anasderkaoui/AutoRCX/README.md

# <p align="center">AutoRCX </b>

Unlocking the full potential of technology with the awe-inspiring autonomous RC car. Whether you want to engage in intense races or experience the joy of exploration, this RC car has got you covered. Its cutting-edge technology will leave you breathless, as you marvel at the incredible capabilities that it possesses. Get ready to be swept away by the excitement and endless possibilities that await you!

# <p align="center">
# <p align="center">
