anasderkaoui/AutoRCX/Additional reports/README.md

This repository is dedicated to more in-depth information about the JETSON NANO dev kit card and ROS utility.</br>
For more flexibility, don't forget Ctrl+F to filter out directly what you want to know !
Some of the topics discussed here are : 
- [Boot and run the Jetson Nano from SSD](https://github.com/anasderkaoui/AutoRCX/blob/main/Additional%20reports/4th%20report.md) instead of SD card or eMMC (internal flash memory)
- Access Jetson Nano via [remote desktop using XRDP or VNC](https://github.com/anasderkaoui/AutoRCX/blob/main/Additional%20reports/1st%20report.md)
- Using Lidar to [perform SLAM as well as autonomous navigation](https://github.com/anasderkaoui/AutoRCX/blob/main/Additional%20reports/6th%20report.md)
- [ssh problem fix host key](https://github.com/anasderkaoui/AutoRCX/blob/main/Additional%20reports/5th%20report.md) while conecting the Jetson Nano board
- [Navigation setup and test](https://github.com/anasderkaoui/AutoRCX/blob/main/Additional%20reports/6th%20report.md) of the AutoRCX
- [Bind USB port with a static name on Linux](https://github.com/anasderkaoui/AutoRCX/blob/main/Additional%20reports/7th%20report.md) and run sudo commands at each openning of the terminal window/tab. And [enable bluetooth automatically at each startup](https://github.com/anasderkaoui/AutoRCX/blob/main/Additional%20reports/7th%20report.md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)
 - [Autonomous navigation fixes and car dimensions](https://github.com/anasderkaoui/AutoRCX/blob/main/Additional%20reports/9th%20report.md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)
 - All the [autonomous navigation config files](https://github.com/anasderkaoui/AutoRCX/blob/main/Additional%20reports/6th%20report.md)
