anasderkaoui/AutoRCX/Odometry/README.md

This is a code to calculate the distance traveled and the current speed of our robot using the **KY-040 rotary encoder**
