anasderkaoui/AutoRCX/CAD (CAO) and Laser Cutting/README.md

In this repository you will find some 3D models for an ARDUINO UNO card case or box along with its lid.
