anasderkaoui/AutoRCX/C++ & Arduino/README.md

Hello!

This is a morse code that I programmed using ARDUINO IDE. It is able to translate any letter or number into its morse code and blink the Arduino UNO card's LED accordingly to each response (dash or dot).

Transfer the 5 files above to your ARDUINO desktop app, hook up your ARDUINO UNO card and try it out !
