anasderkaoui/AutoRCX/IMU/LSM9DS1/README.md

## This is the driver for the LSM9DS1 IMU
