anasderkaoui/AutoRCX/IMU/BNO055/README.md

# Setup the BNO055 IMU

## Hardware part:

- To use this IMU with a raspberry pi4, make sure to connect it just like [the previous IMU](https://github.com/anasderkaoui/AutoRCX/tree/main/SLAM). This type of connection is for **I2C communication**.
- In order to use this IMU with a computer using **USB (UART communication)**, you will need the I2C to USB converter like [the one in the following image](https://www.amazon.fr/DSD-TECH-SH-U09C2-Adaptateur-Programmation/dp/B07TXVRQ7V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) ([backup link](https://www.iot-store.com.au/collections/iot-networking-comms/products/industrial-usb-to-ttl-converter-ft232rl)):
  <p align="center">
      
- Make sure to connect RX ➜ SDA, TX ➜ SCL, Vin ➜ Vcc, Gnd ➜ Gnd and **connect the 3V pin to the PS1 pin, both present on the IMU itself**:
  <p align="center">
      

## Software part:

- [This is the ros2 driver](https://github.com/flynneva/bno055.git) for it.
- Make sure you modify [this line](https://github.com/flynneva/bno055/blob/45e1ff16936101711260c9fda63fbad99376ce3b/launch/bno055.launch.py#L38) in the launch file to "bno055_params_i2c.yaml" if you are using the IMU in I2C mode.
- Also change the "i2c_bus" in [this line](https://github.com/flynneva/bno055/blob/45e1ff16936101711260c9fda63fbad99376ce3b/bno055/params/bno055_params_i2c.yaml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) of the param file to the corresponding one (usually 0 or 1).
- Install required dependencies: `rosdep install --from-paths src -i`
- Finally run: `ros2 launch bno055 bno055.launch.py`
