anasderkaoui/AutoRCX/ROS2 and Arduino wired-wireless communication/IMU (MPU6050) RVIZ2/README.md

A code to get the output of the MPU6050 on RVIZ2 using micro-ros !<br>
**[This package](https://github.com/anasderkaoui/AutoRCX/tree/main/IMU/MPU6050) allows the same thing but without going through micro-ros. It also features a thorough explanation of the TF transform tree!**
