anasderkaoui/AutoRCX/Additional reports/1st report.md

After the final report from the previous sessions, you may have seen that I bricked my Nvidia Jetson Nano card because of some faulty commands.
Today, I succeeded at reflashing it and bringing it back to its normal state.
Here are the steps that I have followed to unbrick it:<br >

1- Follow the steps described in **[this document](https://auvidea.eu/download/Software)**, note that I have an Auvidea carrier board. In this document you will find the **step by step guide to reflash the jetson nano**. An internet connection is required to flash the card.<br >

2- You may encounter some problems as I did. If so, here are some solutions:<br >
   - ERROR 8 : The card did not successfuly boot into recovery mode. You will have to check connection between the jumpers used and the card.<br >
   - ERROR 1 : It has something to do with system cache. All you need to do is restart the laptop you are using to flash the card and change the cable connecting the jetson nano to the laptop.<br >
   - If you encounter any other persisting errors, change the usb cable and the usb port connected to the laptop.

After this, the card should be now good to go. You will need an external monitor and a keyboard to reconfigure it to its original state.<br >

Finally, I want to add one problem that I ran into while trying to move user data from /home to /media/storage/home as explained in [the 19th session's report](https://github.com/anasderkaoui/AutoRCX/blob/main/My%20project%20reports/19th%20session's%20report.md?plain=1).<br >
While following the steps described in that session, I added **<>** to the UUID number that was assigned to my disk partition. After that, the card booted in emergency mode and did not want to boot normaly even after unplugging and plugging back the power cable. I needed an external monitor and a keyboard to figure this out.

rn_image_picker_lib_temp_26d85087-8dd3-40f0-8c19-2a6d464f14e2

After searching, it turns out that these signs **<>** were the problem.
After the card had booted in emergency mode, I pressed the ENTER key to continue.

rn_image_picker_lib_temp_004da67b-501c-4a24-9669-6b4906c3dffc

Then I simply modified the file that contained the UUID number and deleted the <> signs.<br >

rn_image_picker_lib_temp_d4bf532e-9744-44f4-9b78-a2ac7e8fbe27

Eventually, I had to restart the card and the problem was solved !<br >

**As a bonus, I will guide you through two methods, one being more effective than the other, to get the output of your Jetson Nano on your laptop screen without using any external peripherals !**<br >

> [!NOTE]
> You can buy a **wireless HDMI cable** that will save you all the work that follows!

**1- In the first method we will be using VNC (Virtual Network Computing)** (The least effective method because the output is not very smooth). In this method you will need a monitor, a keyboard and if you want also a mouse.
  - First, after booting up the system, you will need to enter this command line in the terminal:<br >
    `sudo vim /usr/share/glib-2.0/schemas/org.gnome.Vino.gschema.xml` This command will open up a file and we will add a key to it.
  - Add this key as shown in the screenshot below:<br >
                  `<key name=’enabled’ type=’b’>`<br >
                  `<summary>Enable remote access to the desktop</summary>`<br >
                  `<description>`<br >
                  `If true, allows remote access to the desktop via the RFB`<br >
                  `protocol. Users on remote machines may then connect to the`<br >
                  `desktop using a VNC viewer.`<br >
                  `</description>`<br >
                  `<default>true</default>`<br >
                  `</key>`<br >
  


  - After that, we will need to compile the file. Run this command to do so: `sudo glib-compile-schemas /usr/share/glib-2.0/schemas`<br >
  - Now search for "Desktop Sharing" in the search bar (can be accessed by pressing the "Windows" key) and open it.<br >
  - Tick the “Allow other users to view your desktop” and also “Allow other users to control your desktop” checkmarks. Then make sure “You must confirm each access to this machine” is turned off. Finally tick the “Require the user to enter this password” checkmark, and enter a password for the VNC session.



  - Open "startup applications" using the search bar. Now, click Add at the right of the box, then type ‘Vino’ in the name box, and then in the command box enter **/usr/lib/vino/vino-server**. Click Save at the bottom right of the box, and then close the app.



  - Next, we need to disable encryption of the VNC connection to get things working. To do this, open the terminal and enter the following commands:<br >
    `gsettings set org.gnome.Vino require-encryption false`<br >
    `gsettings set org.gnome.Vino prompt-enabled false`<br >
  - Now, find the IP address of your Jetson nano board by using "ifconfig" or "hostname -I" command.



In this example it's 192.168.0.106 (You can find it in wlan0->inet)
  - Finally, use this command to check whether your VNC server is running or not: `ps -ef|grep vnc`



Now all you have to do left is install a VNC server (VNC viewer for example) on your laptop and connect to the Jetson Nano using its IP address and password.

**2- Moving on to the better method**, in which we will be using XRDP. XRDP is a free and open-source implementation of Microsoft RDP (Remote Desktop Protocol) server that enables operating systems other than Microsoft Windows (such as Linux) to provide a fully functional RDP-compatible remote desktop experience.
  - First, you need to install XRDP. To do so, open the terminal and run these commands:<br >
    `sudo apt update`<br >
    `sudo apt install xrdp`<br >
    `sudo systemctl enbale xrdp`<br >
    `sudo reboot`<br >
  - After rebooting the system, go to your laptop, search for "Remote Desktop Connection" and open it. Then, click on show options and then type the IP address of your Jetson Nano and username as shown in the screenshot below.



  - Finally, you will be taken to a screen where you need to enter the password of the Jeston Nano to access it.

Now you are able to see the output of the card and use your laptop's keyboard and trackpad to control your Jetson Nano.

Sources:
- [Jetson Nano Remote Connection Methods](https://raspberry-valley.azurewebsites.net/NVIDIA-Jetson-Nano/)
- [Jetson Nano Remote VNC Access](https://medium.com/@bharathsudharsan023/jetson-nano-remote-vnc-access-d1e71c82492b)
