anasderkaoui/AutoRCX/Additional reports/5th report.md

Some warnings and problems related to ssh connecting the Jetson Nano board:

- ... Add correct host key in C:\\Users\\Anas/.ssh/known_hosts to get rid of this message. ... -> Fix: ssh-keygen -R *ip_address_or_hostname*
