anasderkaoui/AutoRCX/Code/NVIDIA JETSON code.md

This is the link to the code of the Autonomous RC car. It is coded automatically via various plateforms like Cuda and Keras.

Link : [Drive Colab Notebooks](https://colab.research.google.com/drive/1U2XdAKOw0V6aW4nJHnTzeedeiRepkBv0?usp=sharing)
