anasderkaoui/AutoRCX/Youness' reports/Report 9.docx

The project involves developing an autonomous driving controller for an electric vehicle. The driving control model was trained using the model.h5 file. The aim is to use this model to control the vehicle's steering and acceleration.

The old code included an implementation of the SimplePIController class which is responsible for controlling the vehicle's steering. However, the code contained some errors and needed improvements to function correctly.

The following modifications were made to the old code:

I removed the import of the h5py library as it was not used in the code.

I updated the fixed speed to 20.

I added prints to display the steering and acceleration values after they have been updated.

I updated the code to save the image only if the image directory is not empty.

I adjusted the SimplePIController class to set the target value to 20.

I defined the values for the variables vehicle_mass, brake_deadband, decel_limit, accel_limit, wheel_radius, wheel_base, steer_ratio, max_lat_accel, and max_steer_angle.

But the new code have a problem because when i run it in the shell he don’t told me any thing, he just goes back to the line like that :

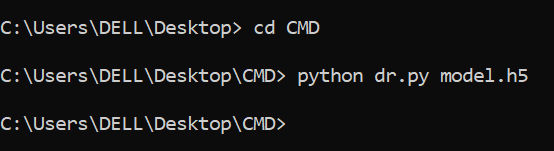
[picture p6: figure]

So I hope that I can fix this problem the next session.

The new code :

import argparse

import base64

import json

import numpy as np

import socketio

import eventlet

import eventlet.wsgi

import time

from PIL import Image

from PIL import ImageOps

from flask import Flask, render_template

from io import BytesIO

from keras.models import load_model

import h5py

# Fix error with Keras and TensorFlow

import tensorflow as tf

tf.compat.v1.disable_eager_execution()

sio = socketio.Server()

app = Flask(__name__)

model = None

prev_image_array = None

class VehicleParams:

def __init__(self):

self.vehicle_mass = 2500 # kg

self.brake_deadband = .1 # range [0,1]

self.decel_limit = -5 # m/s^2

self.accel_limit = 1 # m/s^2

self.wheel_radius = 0.3 # meters

self.wheel_base = 2.8 # meters

self.steer_ratio = 14.8

self.max_lat_accel = 3 # m/s^2

self.max_steer_angle = 8 # degrees

class SimplePIController:

def __init__(self, Kp, Ki):

self.Kp = Kp

self.Ki = Ki

self.set_point = 20

self.error = 0.0

self.integral = 0.0

def run(self, measurement):

self.error = self.set_point - measurement

self.integral += self.error

return self.Kp * self.error + self.Ki * self.integral

class Controller:

def __init__(self, vehicle_params):

self.vehicle_params = vehicle_params

self.steering_controller = SimplePIController(0.1, 0.002)

self.throttle_controller = SimplePIController(0.3, 0.1)

def control(self, current_velocity, dbw_enabled, linear_velocity, angular_velocity):

if not dbw_enabled:

self.throttle_controller.reset()

return 0., 0., 0.

current_velocity = self.velocity_mps_to_kmph(current_velocity)

steering = self.steering_controller.run(current_velocity)

throttle = self.throttle_controller.run(linear_velocity)

brake = 0

if linear_velocity == 0. and current_velocity < 0.1:

throttle = 0

brake = 700 # N*m - to hold the car in place if we are stopped at a light. Acceleration - 1m/s^2

elif throttle < .1 and abs(current_velocity - linear_velocity) < .1:

throttle = 0

decel = max(self.vehicle_params.decel_limit,

self.vehicle_params.accel_limit)

brake = abs(decel) * self.vehicle_params.vehicle_mass * self.vehicle_params.wheel_radius # Torque N*m

return steering, throttle, brake

def reset(self):

self.steering_controller.reset()

self.throttle_controller.reset()

def velocity_mps_to_kmph(self, velocity_mps):

return velocity_mps * 3
