anasderkaoui/AutoRCX/Youness' reports/Report.docx

During this session, we successfully achieved our goal by generating the module.h5 file which contains the information necessary for running the car. However, it is still necessary to develop code that transfers this information to the Udacity software using the shell, in order to establish a connection between the two.

This code implements a deep learning based autonomous driving model using Tensorflow and Keras. It first mounts a Google Drive, then imports the necessary libraries. It then reads a data set called "driving_log.csv" from Google Drive and displays it using Pandas.

The code also performs exploratory data analysis by building a histogram of the car's steering direction and then eliminating directions that are overrepresented in the data. This ensures that the model does not focus on abnormal cases.

The code then loads the images and steering data from the data set and splits it into training and validation sets using scikit-learn's train_test_split.

Finally, the code defines a neural network model using Keras. The model is then trained on the training data and tested on the validation data. The model is saved as a "module.h5" file at the end of the process.

Voici le code :

import argparse

import base64

from datetime import datetime

import os

import shutil

import numpy as np

import socketio

import eventlet

import eventlet.wsgi

from PIL import Image

from flask import Flask

from io import BytesIO

import tensorflow as tf

import h5py

sio = socketio.Server()

app = Flask(__name__)

model = None

prev_image_array = None

class SimplePIController:

def __init__(self, Kp, Ki):

self.Kp = Kp

self.Ki = Ki

self.set_point = 0.

self.error = 0.

self.integral = 0.

def set_desired(self, desired):

self.set_point = desired

def update(self, measurement):

# proportional error

self.error = self.set_point - measurement

# integral error

self.integral += self.error

return self.Kp * self.error + self.Ki * self.integral

controller = SimplePIController(0.1, 0.002)

# 781 is good to 9

# 881

set_speed = 10

controller.set_desired(set_speed)

@sio.on('telemetry')

def telemetry(sid, data):

if data:

# The current steering angle of the car

steering_angle = data["steering_angle"]

# The current throttle of the car

throttle = data["throttle"]

#print("throttle", throttle)

# The current speed of the car

speed = data["speed"]

# The current image from the center camera of the car

imgString = data["image"]

image = Image.open(BytesIO(base64.b64decode(imgString)))

image_array = np.asarray(image)

steering_angle = float(model.predict(image_array[None, :, :, :], batch_size=1))

throttle = controller.update(float(speed))

print(steering_angle, throttle)

send_control(steering_angle, throttle)

# save frame

if args.image_folder != '':

timestamp = datetime.utcnow().strftime('%Y_%m_%d_%H_%M_%S_%f')[:-3]

image_filename = os.path.join(args.image_folder, timestamp)

image.save('{}.jpg'.format(image_filename))

else:

# NOTE: DON'T EDIT THIS.

sio.emit('manual', data={}, skip_sid=True)

@sio.on('connect')

def connect(sid, environ):

print("connect ", sid)

send_control(0, 0)

def send_control(steering_angle, throttle):

sio.emit(

"steer",

data={

'steering_angle': steering_angle.__str__(),

'throttle': throttle.__str__()

},

skip_sid=True)

if __name__ == '__main__':

parser = argparse.ArgumentParser(description='Remote Driving')

parser.add_argument(

'model',

type=str,

help='Path to model h5 file. Model should be on the same path.'

)

parser.add_argument(

'image_folder',

type=str,

nargs='?',

default='',

help='Path to image folder. This is where the images from the run will be saved.'

)

args = parser.parse_args()

model = tf.keras.models.load_model(args.model)

if args.image_folder != '':

print("Creating image folder at {}".format(args.image_folder))

if not os.path.exists(args.image_folder):

os.makedirs(args.image_folder)

else:

shutil.rmtree(args.image_folder)

os.makedirs(args.image_folder)

print("RECORDING THIS RUN ...")

else:

print("NOT RECORDING THIS RUN ...")

# wrap Flask application with engineio's middleware

app = socketio.Middleware(sio, app)

# deploy as an eventlet WSGI server

eventlet.wsgi.server(eventlet.listen(('', 4567)), app)
