anasderkaoui/AutoRCX/Article/AutoRCX presentation.pptx

## AUTORCX La voiture autonome

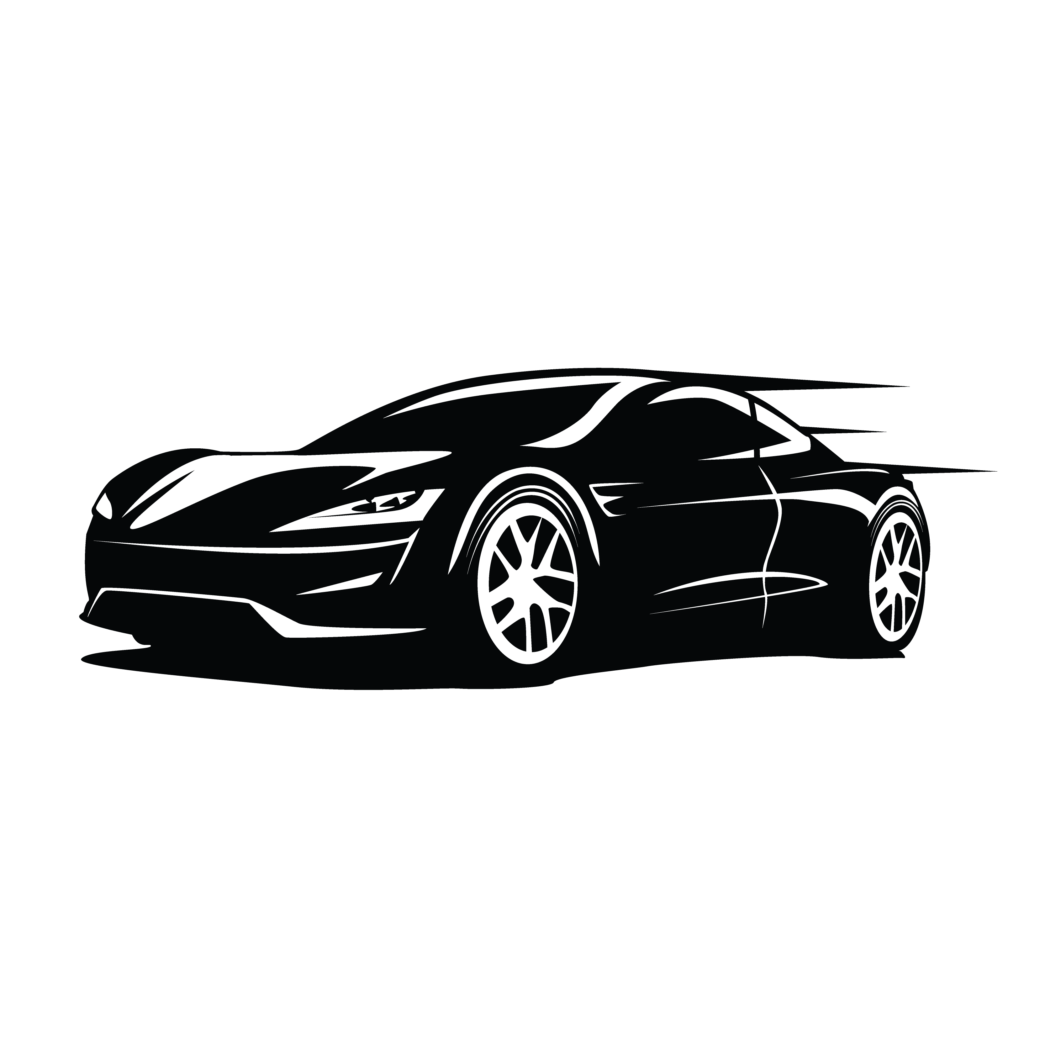
[picture p14: figure]

Youness TALEB - Anas DERKAOUI

## INTRODUCTION

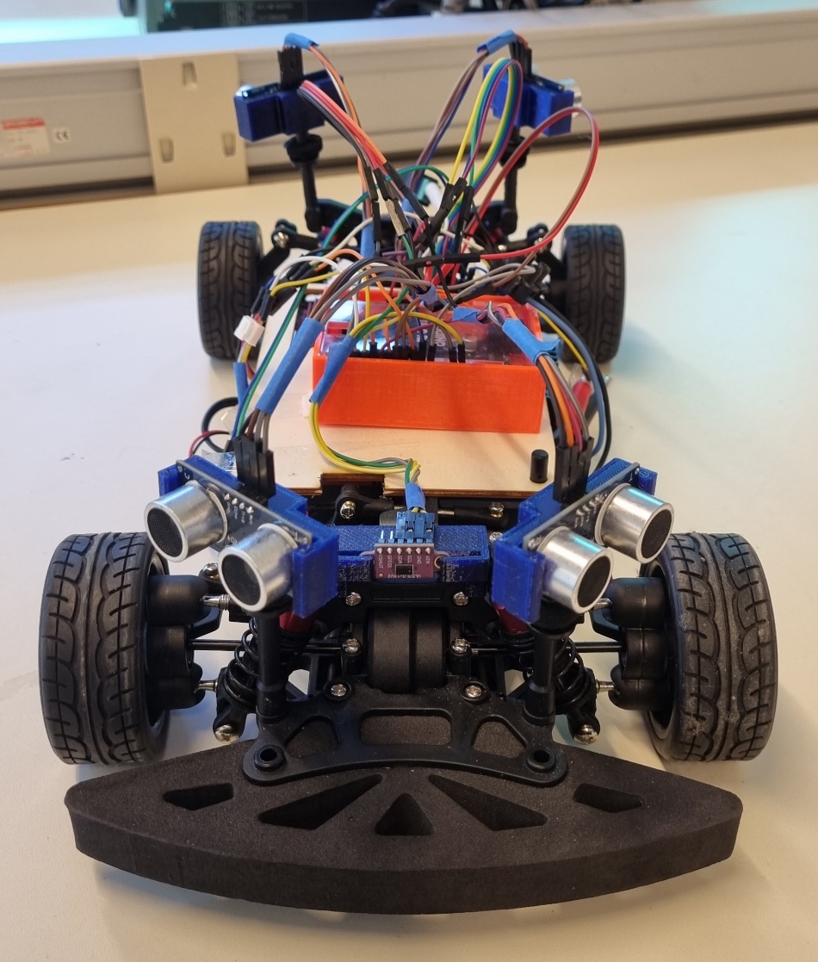
[picture p15: figure]

- Autonomie
- Détection des obstacles
- Aucune intervention externe
- Evitement des obstacles
- Changement de direction

## Composants

Carte Arduino UNO

4 Capteurs ultrason

Capteur laser

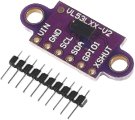
[picture p16: figure]
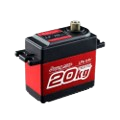
[picture p17: figure]

Servomoteur

Microcontrôleur

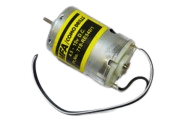
[picture p18: figure]

Moteur DC 4,5 -15V

## Alimentation

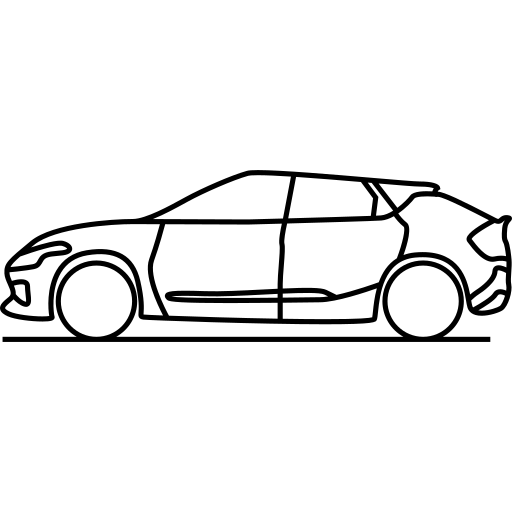
[picture p19: figure]
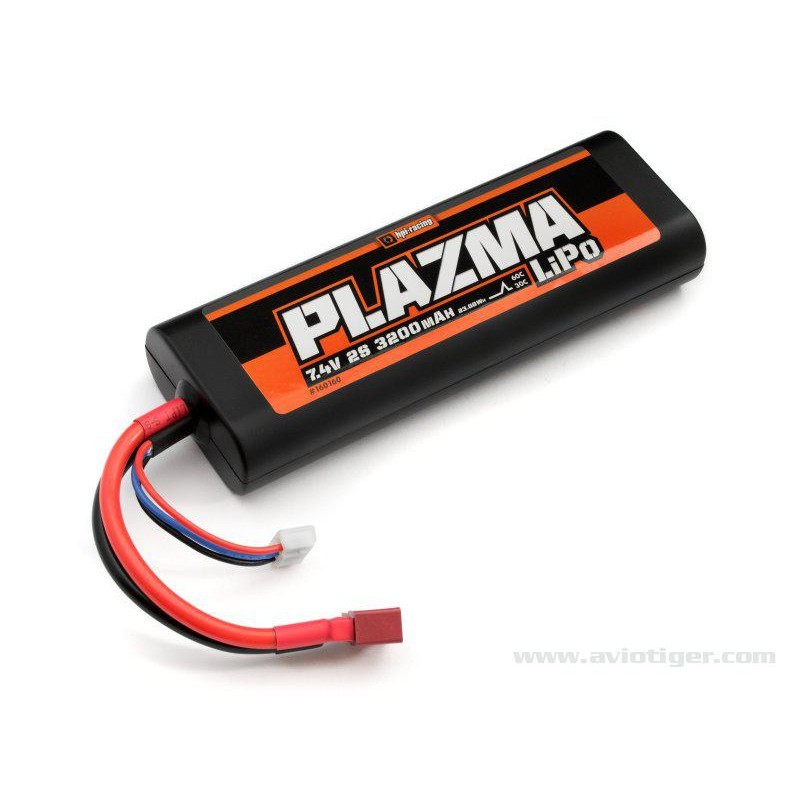
[picture p20: figure]
Alimentation RC Hpi-racing BATTERIE LIPO 7.4V 3200 MAH 30C...
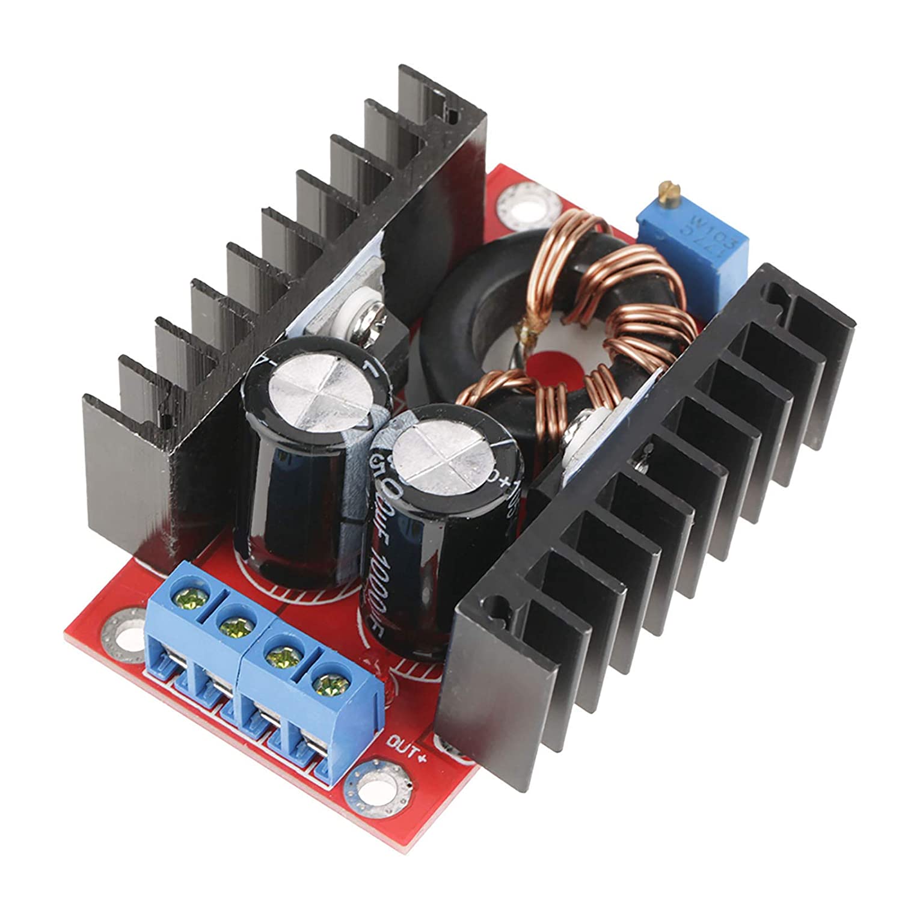
[picture p21: figure]
Convertisseur DC-DC, Module d'augmentation de puissance durable, 150W pratique et utile pour l'alimentation de voiture 12-32V à 12-35V Équipements électroniques Ordinateur portable : Amazon.fr: Informatique

2 convertisseurs
DC-DC

Batterie Li-Po 7,4V ou Ni-MH 7,2V

## Construction et entraînement du modèle 01 02 03

Utilisation de Keras et OpenCV

Prétraitement des données et définition de l'architecture du CNN

Entraînement et sauvegarde du modèle

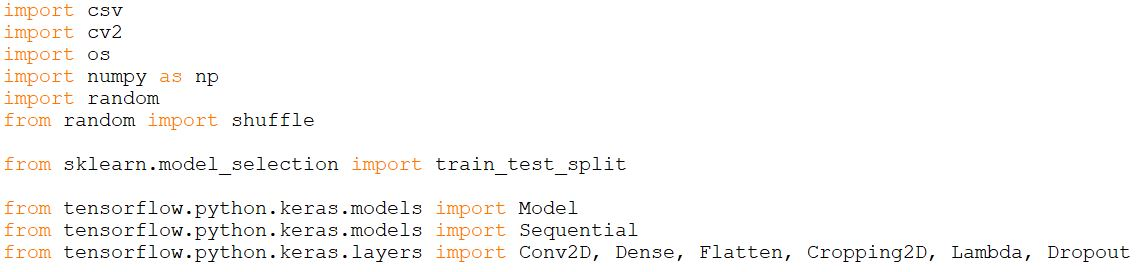
[picture p22: figure]

## Architecture du CNN

- Couches de convolution, de mise à plat (Flatten) et de régularisation (Dropout)
- Fonction de perte et optimiseur

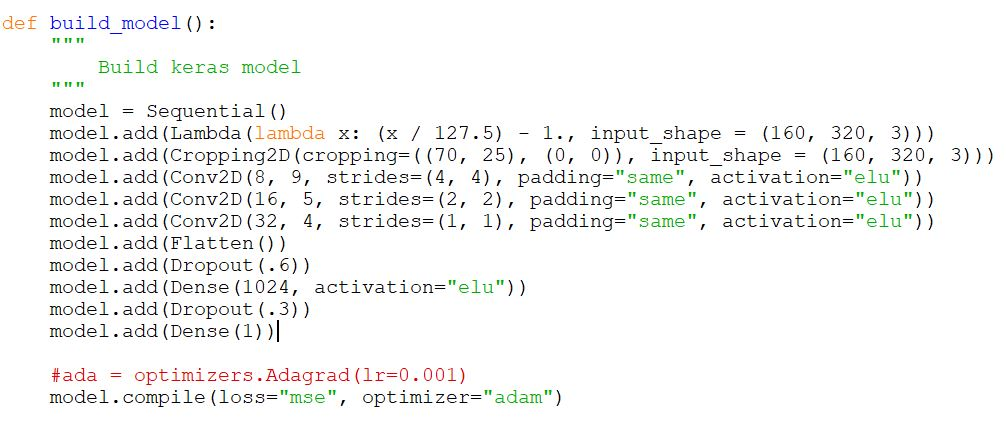
[picture p23: figure]
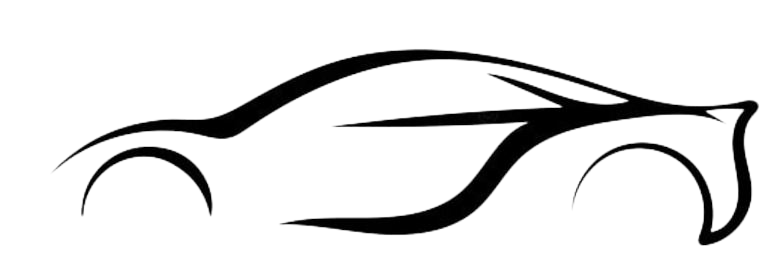
[picture p24: figure]

## Déploiement du modèle dans le simulateur

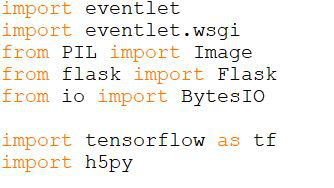
[picture p25: figure]

- Communication avec le simulateur à l'aide de Socket.IO et Flask
- Chargement du modèle pré-entraîné TensorFlow
- Contrôle du véhicule en fonction des prédictions du modèle

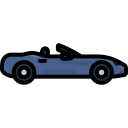
[picture p26: figure]

## Fonction de télémétrie

Lecture et prétraitement des données du simulateur

Prédiction de l'angle de braquage à l'aide du modèle

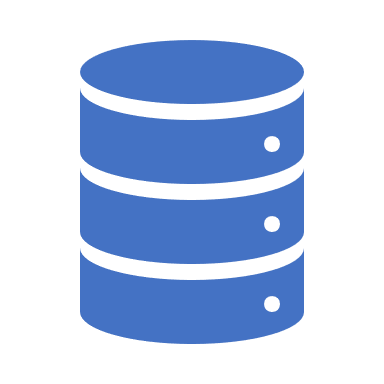
[picture p27: figure]
Base de données avec un remplissage uni
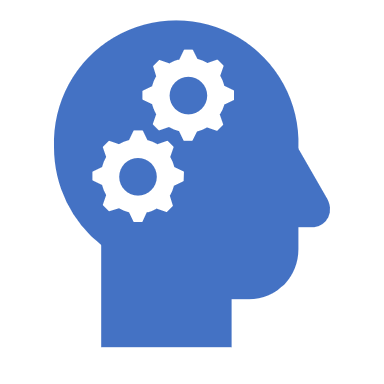
[picture p28: figure]
Head with Gears

Envoi des nouvelles valeurs d'angle de braquage et d'accélérateur au simulateur

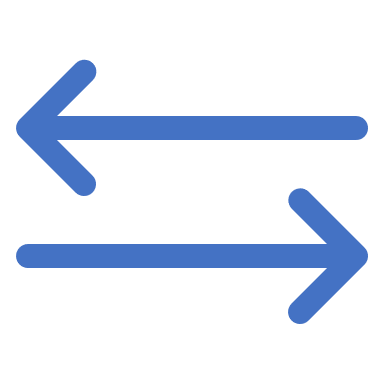
[picture p29: figure]
Transférer avec un remplissage uni

## Merci pour votre attention

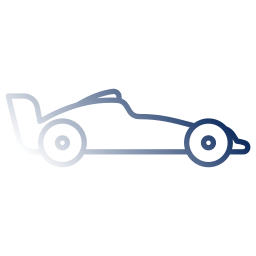
[picture p30: figure]
