anasderkaoui/AutoRCX/Youness' reports/Report 1st session.pdf

## Report 1st session

The objective of this session was to try to write the code for each component. So far, I’ve managed to write the code for the ultrasonic sensor and the code for the SIM800L. However, I have not yet tried the one of the SIM800L because I don’t have it on site, and while trying the one of the ultrasonic sensor I faced some obstacles such as: a cable that was damaged, this made me waste a lot of time looking for where the problem is, but also a mistake that comes from me because I did not pay attention to the sensor Ultrasonic works with microseconds and not with milliseconds.

Here is the complete code that combines that of the two components :

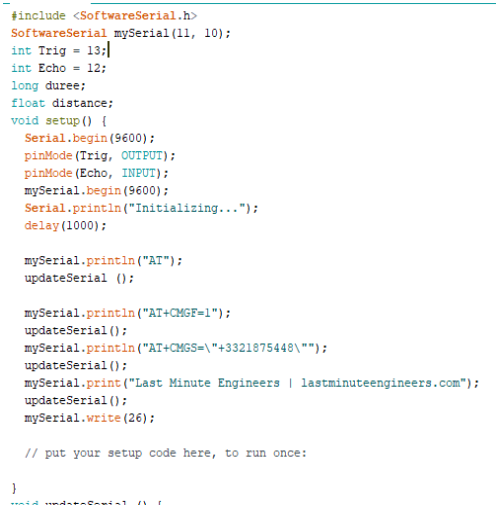
[picture p31: figure]
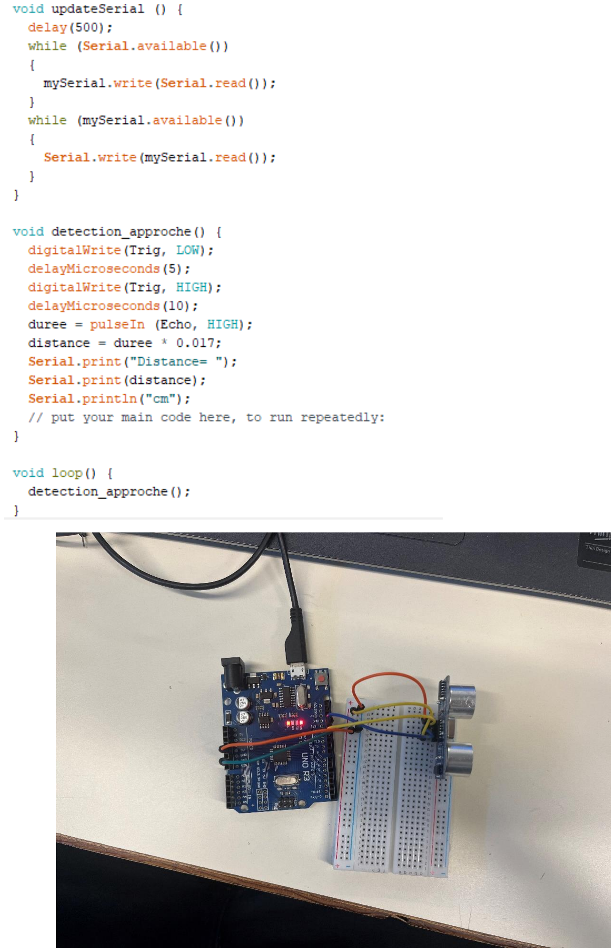
[picture p32: page 2]
