anasderkaoui/AutoRCX/Youness' reports/Report 3rd session.pdf

## Report 3th session

This session, I tried to size the chassis of the car to optimize the space. It took me a long time to find a good picture of the chassis on the internet, to avoid building the whole chassis by myself. I finally managed to import it to Inskape and vectorize it. Then I did the laser cutting, and here’s the result. I also have my comrade Anas to make the code ESP-WROOM-32. This chassis will be used just for the first tests, and after that when we’ve finished all the tests and we’ll have nothing missing, we’ll build a personal chassis that’s more personal and stiff.

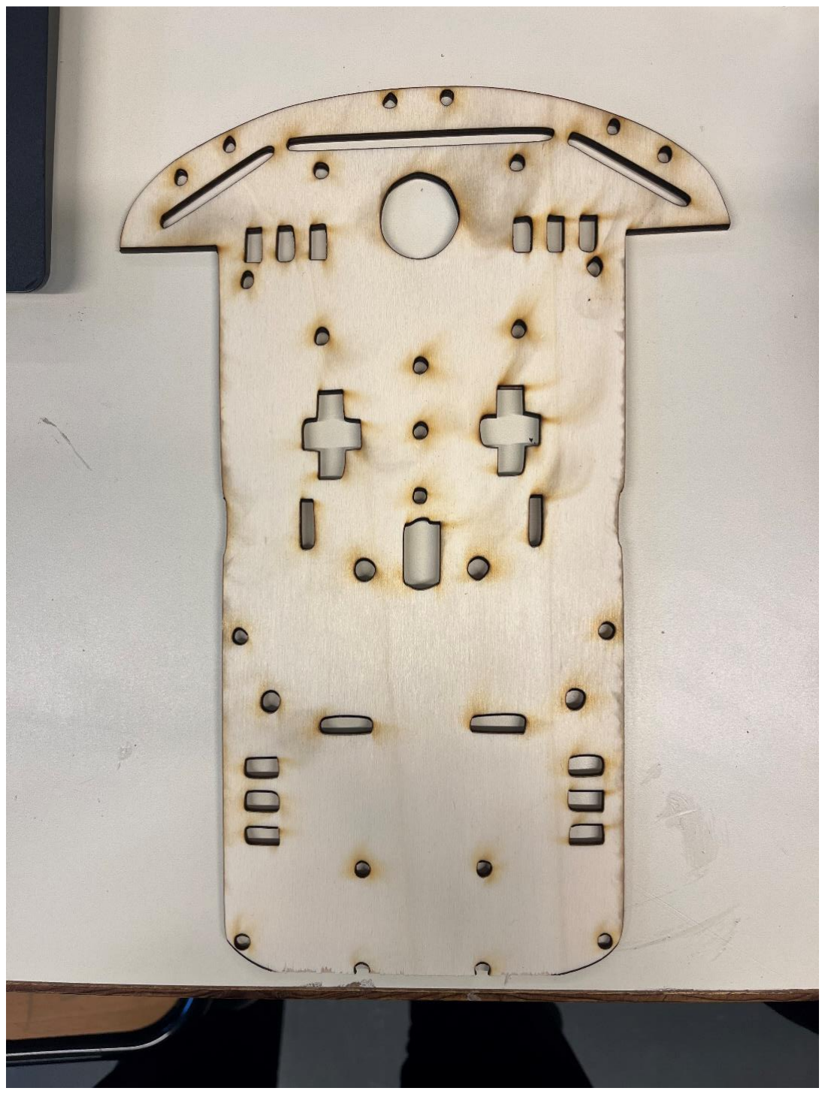
[picture p35: figure]
