anasderkaoui/AutoRCX/Youness' reports/Rapport 6.docx

6th Report

This session and the next two will be devoted to writing the code and testing it on Udacity. We started by installing Anaconda, which is a software containing all the modules we will need to use. We started by using Virtualenv in our Shell, which is a tool for creating isolated Python virtual environments. virtualenv creates a folder that contains all the executables needed to use the packages that a Python project might require.

Then I installed my environment and created my dependencies, which are the following:

Tensorflow, matplotlib, numpy, Image, opencv-python, sklearn, jupyter, scipy, flask-socketio.

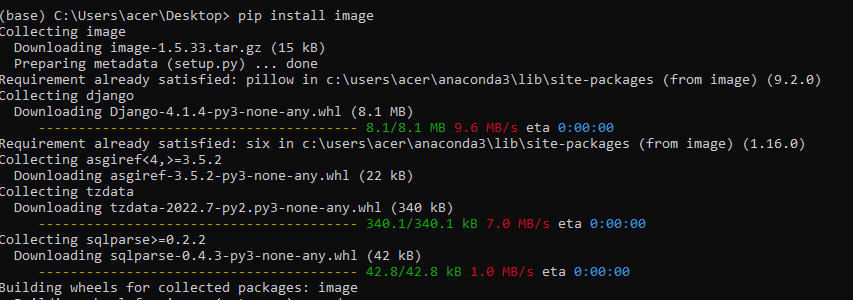
[picture p68: figure]

I train the model using a convolutional neural network predicting one linear output. As I said above, the architecture is built in the build_method method. In order to reduce the overfitting, I used data augmentation by flipping each image of the dataset and by using the left/right camera. I also add dropout just after the last convolution and after the first Fully connected layer. The model used an Adam optimizer, so the learning rate was not tuned manually. Then, for the architecture, the size and the number of filters have been set by many trial and error. For the training data, I used a combination of the central, left and right camera, each one, randomly flip. The training data is a subset of 85% of the total dataset.

THE MODEL.PY :

| import cv2 import csv
| import os
| import numpy as np
| import random
| from random import shuffle
| from sklearn.model_selection import train_test_split
| from tensorflow.python.keras.models import Model
| from tensorflow.python.keras.models import Sequential
| from tensorflow.python.keras.layers import Conv2D, Dense, Flatten, Cropping2D, Lambda, Dropout
| DATA_PATH = "data/driving_log.csv"
| DATA_IMG = "data/"
| def build_model():
| """
| Build keras model
| """
| model = Sequential()
| model.add(Lambda(lambda x: (x / 127.5) - 1., input_shape = (160, 320, 3)))
| model.add(Cropping2D(cropping=((70, 25), (0, 0)), input_shape = (160, 320,
| model.add(Conv2D(8, 9, strides=(4, 4), padding="same", activation="elu"))
| model.add(Conv2D(16, 5, strides=(2, 2), padding="same", activation="elu"))
| model.add(Conv2D(32, 4, strides=(1, 1), padding="same", activation="elu"))
| model.add(Flatten())
| model.add(Dropout(.6))
| model.add(Dense(1024, activation="elu"))
| model.add(Dropout(.3))
| model.add(Dense(1))
| model.compile(loss="mse", optimizer="adam")
| return model
| def get_data(log_content, index_list, batch_size, strict=True):
| """
| Return Data from the simulator
| **input:
| *log_content (2dim Array) Data from the log file
| *index_list: Index to used to create each batch
| *batch_size (Int) Size of each batch
| """
| images, rotations = [], []
| while True:
| if not strict:
| shuffle(index_list)
| for index in index_list:
| # Futur angle correction
| angle_correction = [0., 0.25, -.25]
| i = random.choice([0, 1, 2]) # [Center, Left, Right]
| img = cv2.imread(os.path.join(DATA_IMG, log_content[index][i]).replace(" ", ""))
| if img is None: continue
| img = cv2.cvtColor(img, cv2.COLOR_BGR2RGB)
| rotation = float(log_content[index][3])
| rotation = rotation + angle_correction[i]
| if random.random() > 0.5:
| img = cv2.flip(img, 1)
| rotation = rotation * -1
| images.append(img)
| rotations.append(rotation)
| if len(images) >= batch_size:
| yield np.array(images), np.array(rotations)
| images, rotations = [], []
| def main():
| """
| Main function to train the model
| """
| with open(DATA_PATH, "r") as f:
| content = [line for line in csv.reader(f)]
| random_indexs = np.array(range(len(content)))
| train_index, valid_index = train_test_split(random_indexs, test_size=0.15)
| model = build_model()
| print("Train size = %s" % len(train_index))
| print("Valid size = %s" % len(valid_index))
| BATCH_SIZE = 64
| model.fit_generator(
| generator=get_data(content, train_index, BATCH_SIZE, strict=False),
| steps_per_epoch=len(train_index) / BATCH_SIZE,
| validation_data=get_data(content, valid_index, BATCH_SIZE, strict=True),
| validation_steps=len(valid_index) / BATCH_SIZE,
| epochs=12)
| model.save("model.h5")
| if __name__ == '__main__':
| main()
