anasderkaoui/AutoRCX/IMU/MPU9250/src/magnetometer_scatter.png

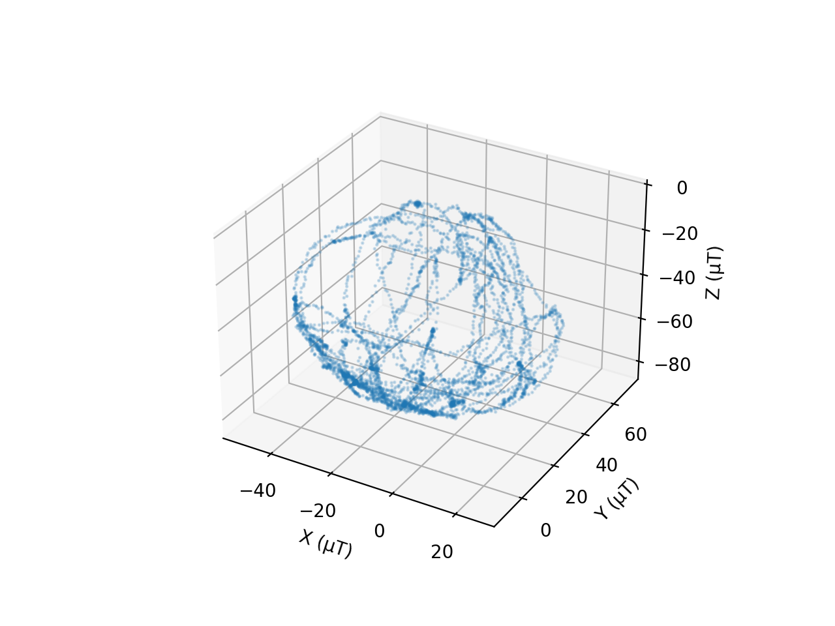
IMU/MPU9250/src/magnetometer_scatter.png
