anasderkaoui/AutoRCX/CAD (CAO) and Laser Cutting/Boitier Youness TALEB.stl

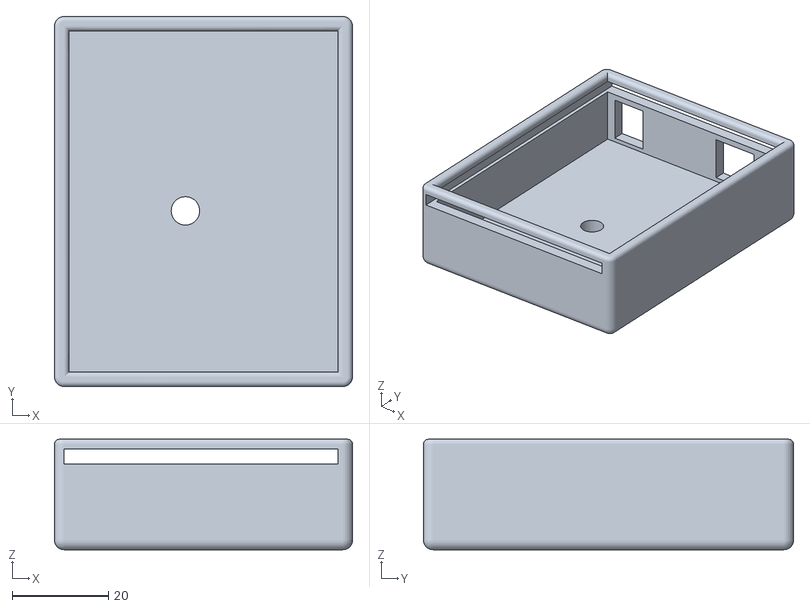
[picture p70: CAD file, 2022-11-16]
CAD (CAO) and Laser Cutting/Boitier Youness TALEB.stl
62.0 x 77.0 x 23.0
