anasderkaoui/AutoRCX/(list of files, cad)

Other CAD files:
CAD (CAO) and Laser Cutting/boîte arduino version finale.f3d
