anasderkaoui/AutoRCX/IMU/MPU9250/src/test_data.csv

Time | Distance (m) | Velocity (m/s) | Acceleration (m/s²) | Jerk (m/s³)
1753370297.869718 | 0.0 | 0.0 | 0.0 | 0.0
1753370298.066915 | 0.0 | 0.0 | 0.0 | 0.0
1753370298.1669445 | 0.0 | 0.0 | 0.0 | 0.0
1753370298.2673845 | 0.0 | 0.0 | 0.0 | 0.0
1753370298.4670632 | 0.0 | 0.0 | 0.0 | 0.0
1753370298.5673578 | 0.0 | 0.0 | 0.0 | 0.0
1753370298.7672765 | 0.0 | 0.0 | 0.0 | 0.0
1753370298.8673503 | 0.0 | 0.0 | 0.0 | 0.0
1753370299.0672915 | 0.0 | 0.0 | 0.0 | 0.0
1753370299.2672644 | 0.0 | 0.0 | 0.0 | 0.0
1753370299.4671724 | 0.0 | 0.0 | 0.0 | 0.0
1753370299.5673802 | 0.0 | 0.0 | 0.0 | 0.0
1753370299.7672908 | 0.0 | 0.0 | 0.0 | 0.0
1753370299.8673255 | 0.0 | 0.0 | 0.0 | 0.0
1753370300.0715659 | 0.0 | 0.0 | 0.0 | 0.0
1753370300.2672007 | 0.0 | 0.0 | 0.0 | 0.0
1753370300.4672937 | 0.0 | 0.0 | 0.0 | 0.0
1753370300.5673182 | 0.0 | 0.0 | 0.0 | 0.0
1753370300.6673536 | 0.0 | 0.0 | 0.0 | 0.0
1753370300.867202 | 0.0 | 0.0 | 0.0 | 0.0
1753370300.967373 | 0.0 | 0.0 | 0.0 | 0.0
1753370301.1672008 | 0.0 | 0.0 | 0.0 | 0.0
1753370301.2672422 | 0.0 | 0.0 | 0.0 | 0.0
1753370301.4675748 | 0.0 | 0.0 | 0.0 | 0.0
1753370301.6671386 | 0.0 | 0.0 | 0.0 | 0.0
1753370301.8671196 | 0.0 | 0.0 | 0.0 | 0.0
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
