anasderkaoui/AutoRCX/C++ & Arduino/Main.ino

// This is where the characters need to be typed so as to translate them in morse code and blink the LED light of the Arduino UNO board accordingly

#include "Traducteur.h" // Includes "Traducteur.h" that has all the needed functions for the morse code to work (including "LettreMorse.h")

const int led = 13;  // The pin 13 that corresponds to the LED on the Arduino UNO board
Traducteur traducteur=Traducteur();  // Creates an object of type "Traducteur" to allow us to use the functions in "Traducteur.h" that are defined in "Traducteur.cpp"
char phrase[100] = "Put the phrase/word to translate in here";

void setup() {

  Serial.begin(9600);  // The speed at which we can communicate with the Arduino UNO R3 board
  pinMode(led,OUTPUT);  // Defining pin that will be used as an output (13 our this case)
  Serial.print("Translation of : ");
  Serial.println(phrase);
  traducteur.morse(phrase); // The input which will be translated to morse code
  Serial.println(" End of translation! ");

}

void loop() {
  
}
