anasderkaoui/AutoRCX/(commit log)

2022-11-15 Add files via upload
    Boîtier pour carte Arduino Uno R3
    [boîte arduino version finale.f3d]
2022-11-25 Rename Couvercle version finale.svg to CAD (CAO) and Laser Cutting/Couvercle version finale.svg
2022-11-25 Rename Couvercle Youness TALEB.svg to CAD (CAO) and Laser Cutting/Couvercle Youness TALEB.svg
2022-11-27 Rename LettreMorse.cpp.ino to C++ & Arduino/LettreMorse.cpp.ino
2022-11-27 Rename LettreMorse.h to C++ & Arduino/LettreMorse.h
2022-11-27 Rename Main.ino to C++ & Arduino/Main.ino
2022-11-27 Rename Traducteur.cpp to C++ & Arduino/Traducteur.cpp
2022-11-27 Rename Traducteur.h to C++ & Arduino/Traducteur.h
2023-01-19 Update and rename Autonomous RC Car code.md to Autonomous RC Car ARDUINO code.md
2023-01-21 Update Autonomous RC Car ARDUINO code.md
2023-01-27 Create NVIDIA JETSON code
2023-01-27 Update and rename NVIDIA JETSON code to NVIDIA JETSON code.md
2023-01-27 Update NVIDIA JETSON code.md
2023-05-08 Create New improved ARDUINO code for AutoRCX.md
2023-05-08 Rename New improved ARDUINO code for the AutoRCX.md
2023-05-08 Rename Autonomous RC Car ARDUINO code.md
2024-02-28 Update add IMU soon
2024-04-08 How to visualize the IMU README.md
2024-06-05 Add difference between base link and base footprint
2024-06-05 ADD info about imu and base link
2024-06-09 Code to send/test control over arduino
2024-06-16 Added rviz config and car's urdf
2024-11-18 Add wireless HDMI availability
2025-01-09 Add robot's URDF
2025-01-14 Create 11th report.md - odom - robot_loca - IMU
2025-03-04 Ditch Arduino and connect directly to jetson
2025-10-29 New code for odometry
2025-12-18 added MPU9250 ROS2 driver
    [test_data.csv]
2025-12-18 Added calibration process for IMU
2025-12-18 Added LSM9DS1 ROS2 driver
2025-12-18 Add README for odometry
